Sparod/AirCat-A10/hardware/datasheet/image/650px-A10-OLinuXino-LIME-FRONT.jpg

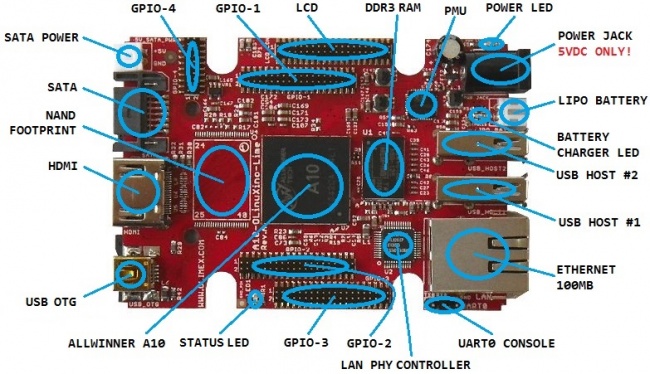
hardware/datasheet/image/650px-A10-OLinuXino-LIME-FRONT.jpg
