Sparod/AirCat-A10/hardware/datasheet/image/650px-A10-OLinuXino-LIME-BACK.jpg

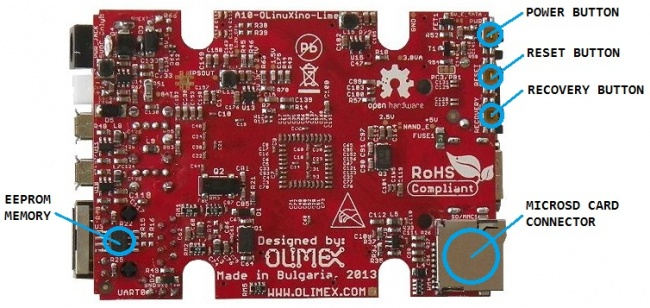
hardware/datasheet/image/650px-A10-OLinuXino-LIME-BACK.jpg
