Sparod/AirCat-A10/hardware/datasheet/image/a10-olinuxino.png

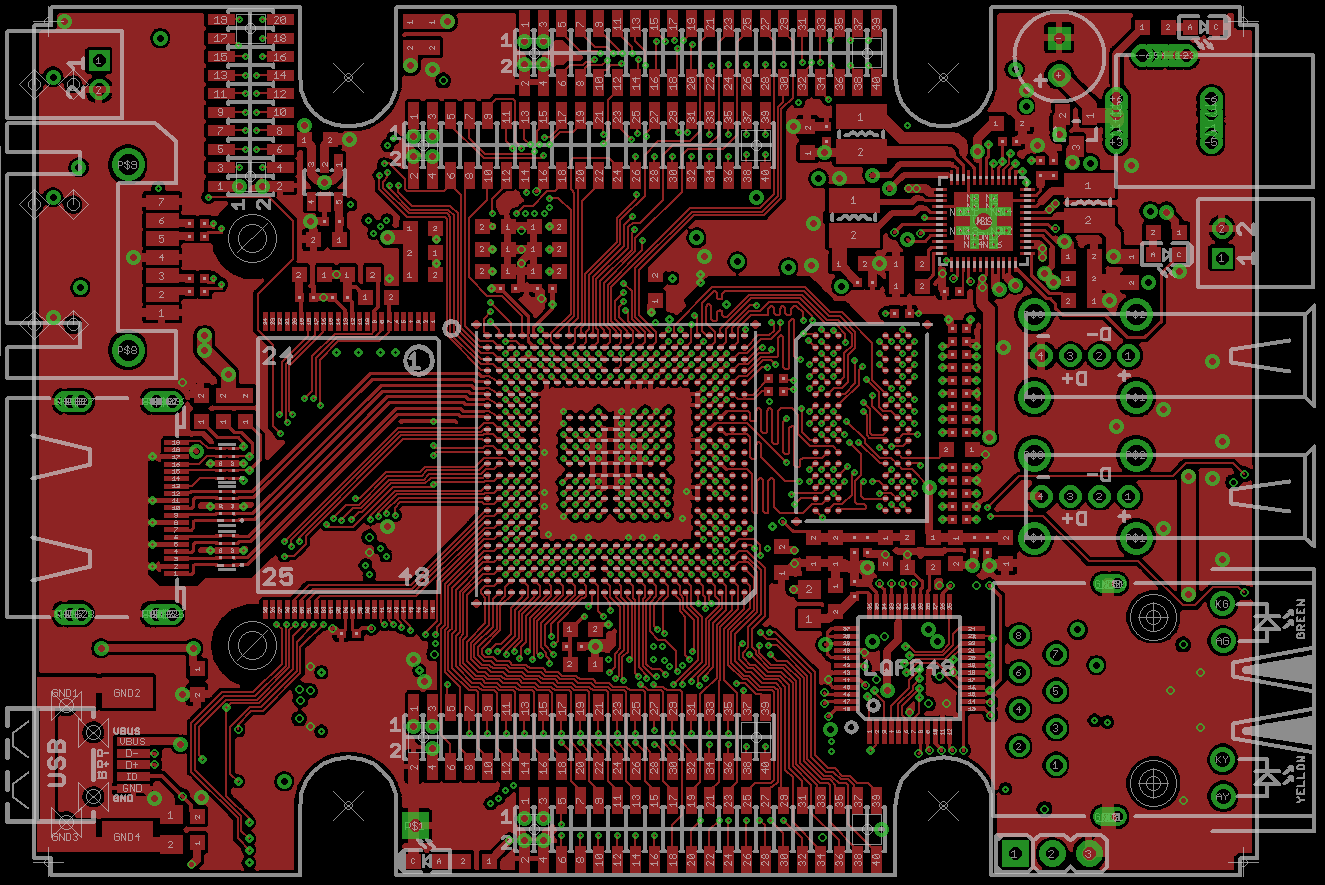
hardware/datasheet/image/a10-olinuxino.png
