Sparod/AirCat-A10/hardware/eagle/OSHpark_Board_Outline.png

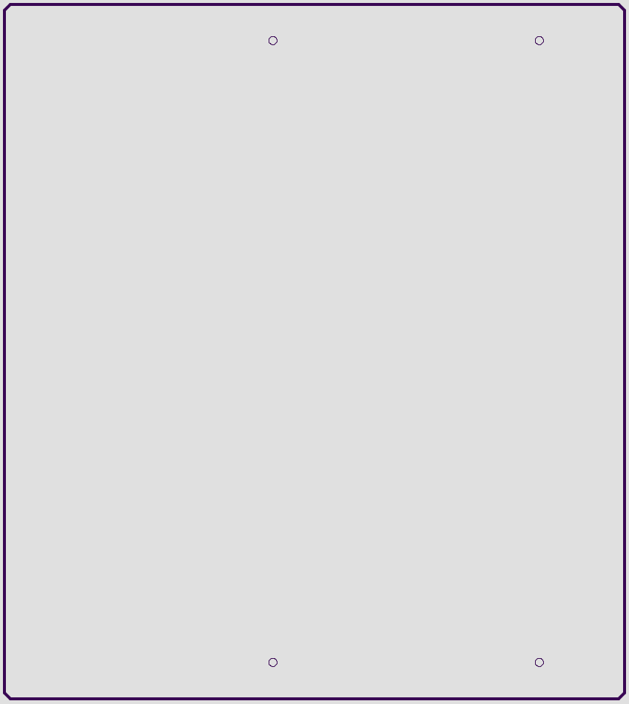
hardware/eagle/OSHpark_Board_Outline.png
