Sparod/AirCat-A10/hardware/eagle/OSHpark_bottom.png

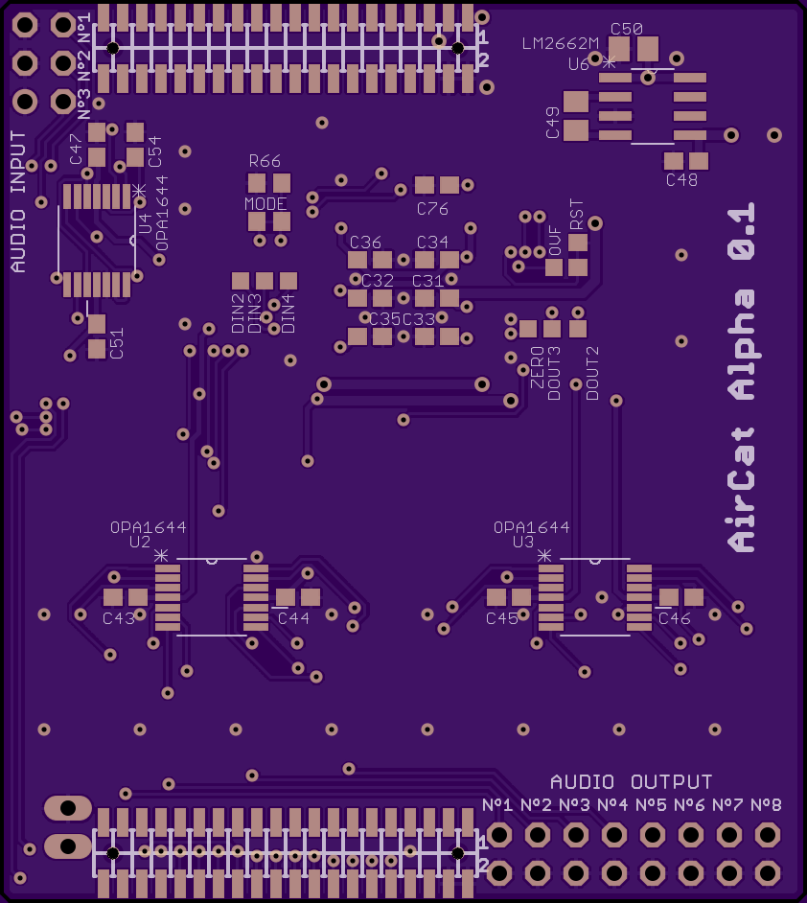
hardware/eagle/OSHpark_bottom.png
