Sparod/AirCat-A10/hardware/eagle/OSHpark_bottom_copper.png

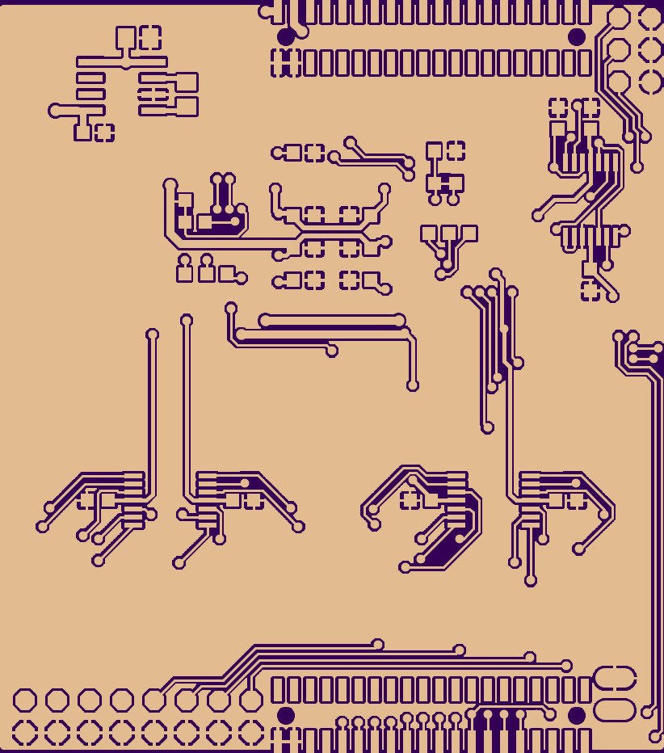
hardware/eagle/OSHpark_bottom_copper.png
