Sparod/AirCat-A10/hardware/eagle/OSHpark_bottom_Silk_Screen.png

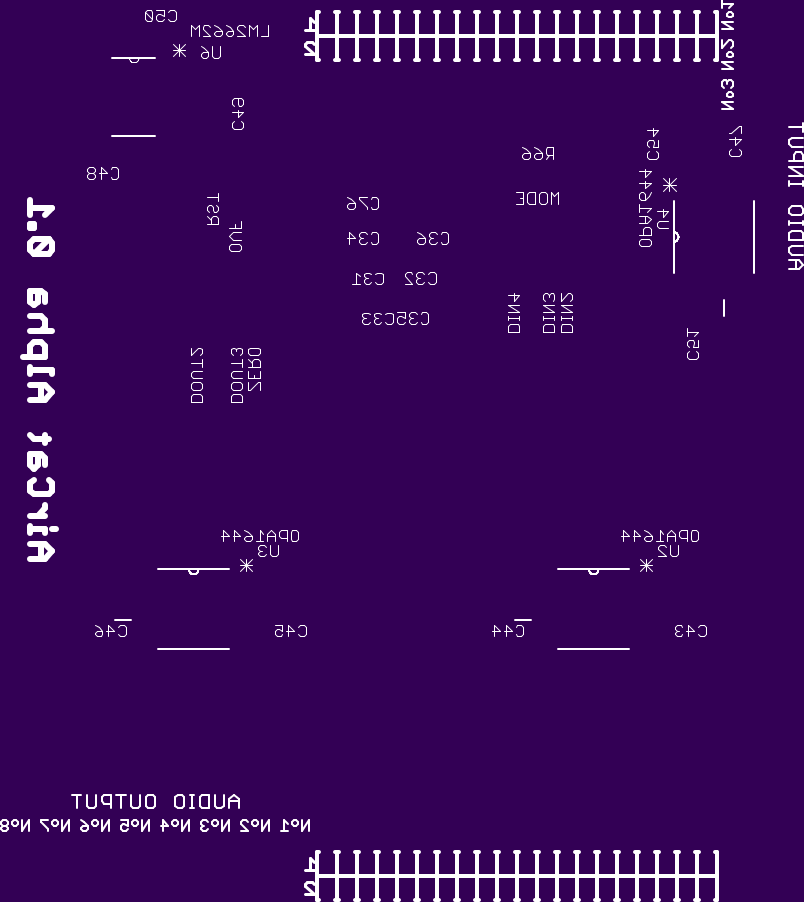
hardware/eagle/OSHpark_bottom_Silk_Screen.png
