Sparod/AirCat-A10/hardware/eagle/OSHpark_Drills.png

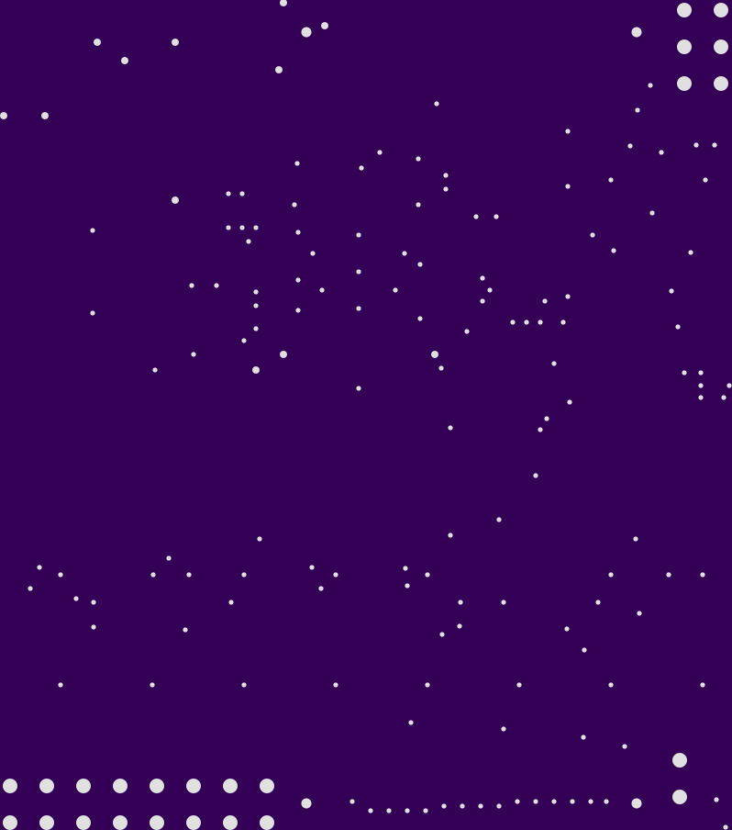
hardware/eagle/OSHpark_Drills.png
