Sparod/AirCat-A10/hardware/eagle/OSHpark_top.png

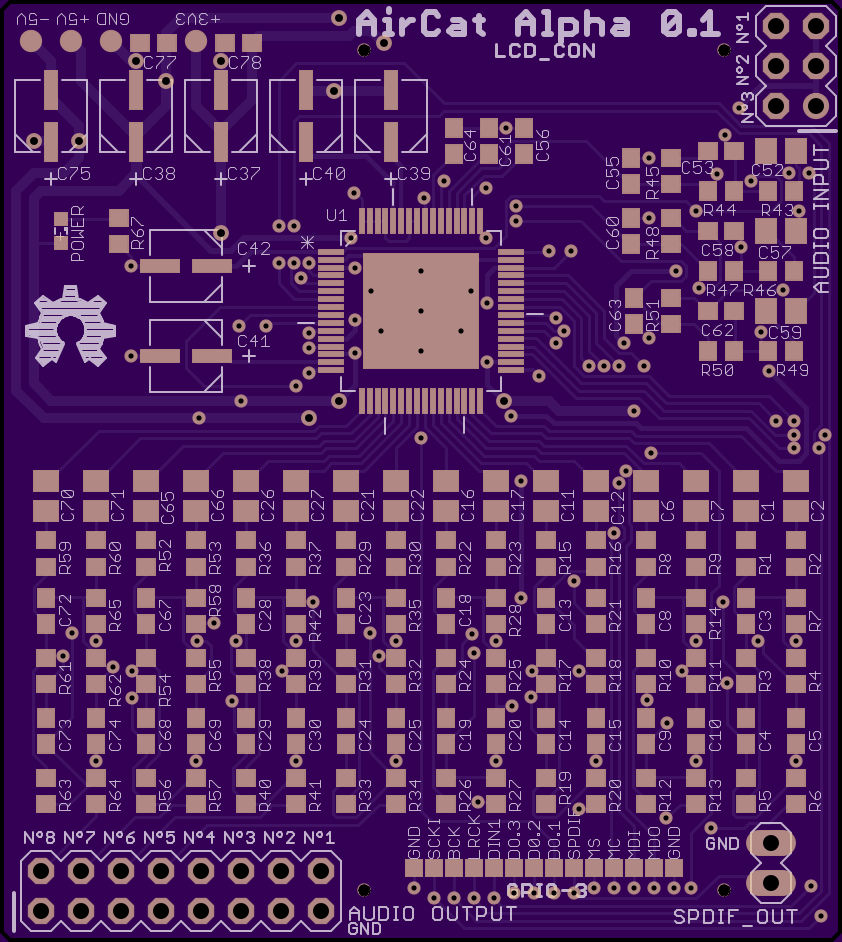
hardware/eagle/OSHpark_top.png
