Sparod/AirCat-A10/hardware/eagle/OSHpark_top_copper.png

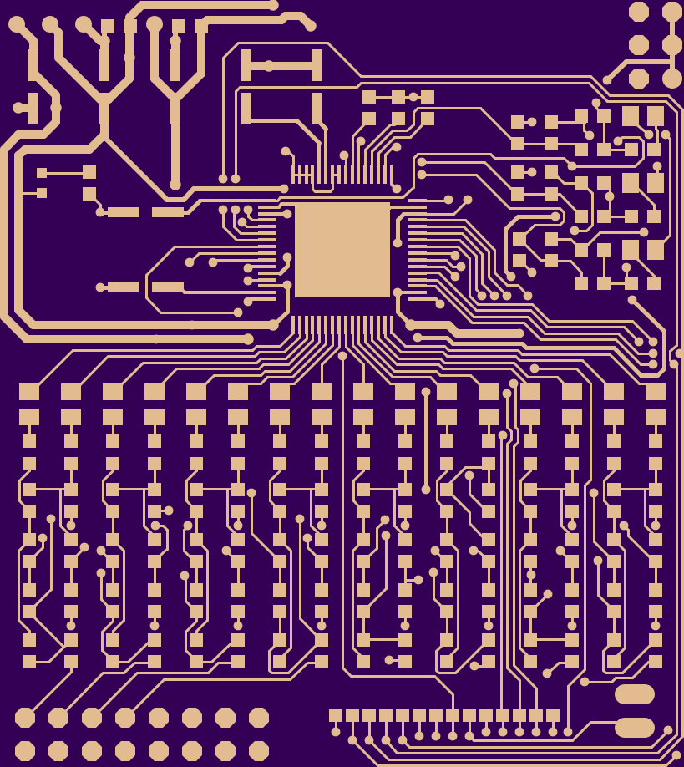
hardware/eagle/OSHpark_top_copper.png
