Sparod/AirCat-A10/hardware/eagle/OSHpark_top_Silk_Screen.png

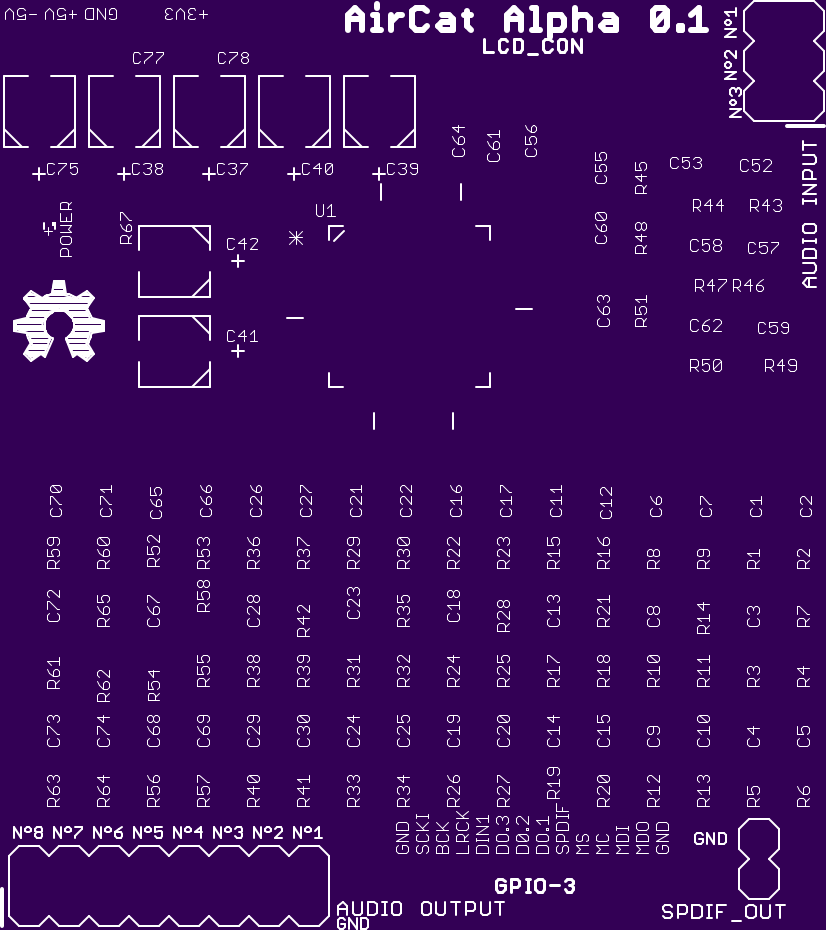
hardware/eagle/OSHpark_top_Silk_Screen.png
