Sparod/AirCat-A10/hardware/eagle/bom.xlsx

Sheet: BOM
AirCat audio shield - BOM
taxes excluded
category | value/description | manufacturer name | manufacturer ref | vendor name | vendor ref | qty | € / u / 1pc | € / u / 100pcs | € / 1pc | € / 100pc | link | datasheet
capacitor | SMD BOITIER B 10µF 35V | PANASONIC | EEEFK1V100UR | Farnell | 2254444 | 7 | 0.410 | 0.148 | 2.870 | 1.036 | http://fr.farnell.com/panasonic/eeefk1v100ur/condensateur-boitier-b-10uf-35v/dp/9695826 | http://www.farnell.com/datasheets/1676921.pdf
capacitor | SMD 0805" 10 µF | MULTICOMP | MCCA000268 | Farnell | 1759136 | 21 | 0.048 | 0.048 | 1.008 | 1.008 | http://fr.farnell.com/multicomp/mcca000268/condensateur-mlcc-08055v-6-3v-10uf/dp/1759136 | http://www.farnell.com/datasheets/1723208.pdf
capacitor | SMD 0603" 1 µF | MULTICOMP | MCCA000521 | Farnell | 1759398 | 12 | 0.009 | 0.009 | 0.108 | 0.108 | http://fr.farnell.com/multicomp/mcca000521/condensateur-mlcc-06035v-10v-1uf/dp/1759398 | http://www.farnell.com/datasheets/1723208.pdf
capacitor | SMD 0603" 680 pF | MULTICOMP | MC0603B681K500CT | Farnell | 1759083 | 16 | 0.007 | 0.006 | 0.112 | 0.096 | http://fr.farnell.com/multicomp/mc0603b681k500ct/condensateur-mlcc-0603-x7r-50v/dp/1759083 | http://www.farnell.com/datasheets/1792107.pdf
capacitor | SMD 0603" 3.3 nF | MULTICOMP | MC0603B332J500CT | Farnell | 2320807 | 8 | 0.008 | 0.007 | 0.064 | 0.056 | http://fr.farnell.com/multicomp/mc0603b332j500ct/condensateur-mlcc-3-3nf-50v-x7r/dp/2320807 | http://www.farnell.com/datasheets/1792107.pdf
capacitor | SMD 0603" 22 nF | MULTICOMP | MC0603B223K250CT | Farnell | 1759027 | 6 | 0.009 | 0.008 | 0.054 | 0.048 | http://fr.farnell.com/multicomp/mc0603b223k250ct/condensateur-mlcc-0603-x7r-25v/dp/1759027 | http://www.farnell.com/datasheets/1792107.pdf
capacitor | SMD 0603" 2.2 nF | MULTICOMP | MC0603B222J500CT | Farnell | 2320806 | 6 | 0.009 | 0.008 | 0.054 | 0.048 | http://fr.farnell.com/multicomp/mc0603b223k250ct/condensateur-mlcc-0603-x7r-25v/dp/1759027 | http://www.farnell.com/datasheets/1792107.pdf
capacitor | SMD 0603" 100 nF | MULTICOMP | MC0603B104K250CT | Farnell | 1759037 | 5 | 0.007 | 0.006 | 0.035 | 0.030 | http://fr.farnell.com/multicomp/mc0603b104k250ct/condensateur-mlcc-0603-x7r-25v/dp/1759037 | http://www.farnell.com/datasheets/1792107.pdf
connector | 0.1" male thru-hole 2x08 | MULTICOMP | 2213S-16G | Farnell | 1593445 | 1 | 0.830 | 0.640 | 0.830 | 0.640 | http://fr.farnell.com/multicomp/2213s-16g/embase-male-2-rangee-vert-16voies/dp/1593445 | http://www.farnell.com/datasheets/1697539.pdf
connector | 0.05" female SMD 2x20 | OLIMEX | FEMALE-YAV36P-2x20 | OLIMEX | FEMALE-YAV36P-2x20 | 2 | 0.320 | 0.256 | 0.640 | 0.512 | https://www.olimex.com/Products/Components/Connectors/FEMALE-YAV36P-2x20/
connector | 0.1" male thru-hole 2x03 | MULTICOMP | 2213S-06G | Farnell | 1593440 | 1 | 0.360 | 0.320 | 0.360 | 0.320 | http://fr.farnell.com/multicomp/2213s-06g/embase-male-2-rangee-vert-6voies/dp/1593440?Ntt=2213S-06G | http://www.farnell.com/datasheets/1697530.pdf
connector | 0.05" male SMD 1x2 | MULTICOMP | 2211S-02G | Farnell | 1593411 | 1 | 0.065 | 0.027 | 0.065 | 0.027 | http://fr.farnell.com/multicomp/2211s-02g/embase-male-1-rangee-vert-2voies/dp/1593411 | http://www.farnell.com/datasheets/1518407.pdf
ic | audio op amp | TEXAS INSTRUMENTS | OPA1644AIPW | Farnell | 1882283 | 3 | 4.880 | 3.470 | 14.640 | 10.410 | http://fr.farnell.com/texas-instruments/opa1644aipw/ampli-op-jfet-11mhz-quad-14tssop/dp/1882283 | http://www.farnell.com/datasheets/1633936.pdf
ic | audio codec | TEXAS INSTRUMENTS | PCM3168APAP | Farnell | 1689419 | 1 | 11.860 | 5.830 | 11.860 | 5.830 | http://fr.farnell.com/texas-instruments/pcm3168apap/24bit-audio-code-64tqfp/dp/1689419?ref=lookahead | http://www.farnell.com/datasheets/1815267.pdf
ic | buck tension converter | TEXAS INSTRUMENTS | LM2662M | Farnell | 9306803 | 1 | 1.700 | 1.510 | 1.700 | 1.510 | http://fr.farnell.com/texas-instruments/lm2662m/convertisseur-de-tension-cms/dp/9306803 | http://www.farnell.com/datasheets/77958.pdf
led | SMD 0603" Green 10mcd | KINGBRIGHT | KP-1608SGC | Farnell | 8529833 | 1 | 0.076 | 0.069 | 0.076 | 0.069 | http://fr.farnell.com/kingbright/kp-1608sgc/led-cms-0603-vert/dp/8529833 | http://www.farnell.com/datasheets/55768.pdf
pcb |  |  |  | OHSpark.com |  | 1 | 4.949 | 0.990 | 4.949 | 0.990 | oshpark.com
resistor | SMD 0603" 5.6kR | MULTICOMP | MCMR06X5601FTL | Farnell | 2073537 | 16 | 0.008 | 0.008 | 0.128 | 0.128 | http://fr.farnell.com/multicomp/mcmr06x5601ftl/resistance-0603-5k6-1-anti-sulfur/dp/2073537 | http://www.farnell.com/datasheets/1716707.pdf
resistor | SMD 0603" 7.5kR | MULTICOMP | MCMR06X7501FTL | Farnell | 2073570 | 16 | 0.008 | 0.008 | 0.128 | 0.128 | http://fr.farnell.com/multicomp/mcmr06x7501ftl/resistance-0603-7k5-1-anti-sulfur/dp/2073570 | http://www.farnell.com/datasheets/1716707.pdf
resistor | SMD 0603" 3kR | MULTICOMP | MCMR06X3001FTL | Farnell | 2073461 | 3 | 0.008 | 0.008 | 0.024 | 0.024 | http://fr.farnell.com/multicomp/mcmr06x3001ftl/resistance-0603-3k-1-anti-sulfur/dp/2073461 | http://www.farnell.com/datasheets/1716707.pdf
resistor | SMD 0603" 150R | MULTICOMP | MCMR06X1500FTL | Farnell | 2073388 | 1 | 0.009 | 0.009 | 0.009 | 0.009 | http://fr.farnell.com/multicomp/mcmr06x1500ftl/resistance-0603-150r-1-anti-sulfur/dp/2073388 | http://www.farnell.com/datasheets/1716707.pdf
resistor | SMD 0603" 220kR | YAGEO (PHYCOMP) | RC0603FR-07220KL | Farnell | 9238760 | 1 | 0.005 | 0.005 | 0.005 | 0.005 | http://fr.farnell.com/yageo-phycomp/rc0603fr-07220kl/resistance-rc22h-0603-220k/dp/9238760 | http://www.farnell.com/datasheets/443971.pdf
TOTAL |  |  |  |  |  | 130 |  |  | 39.72 € | 23.03 €
taxe rate = | 20% | France VAT |  |  |  |  |  | taxes | 7.94 € | 4.61 €
 |  |  |  |  |  |  |  | grand total | 47.66 € | 27.64 €

Sheet: other
2pcs Video AV Balun 3.5mm 1/8"stereo male plug to AV Screw Terminal Plug adapter | http://www.ebay.com/itm/2pcs-Video-AV-Balun-3-5mm-1-8-stereo-male-plug-to-AV-Screw-Terminal-Plug-adapter-/231204744595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
Audio 4 Female Jack RCA Socket Connectors (10-Piece Pack) | http://www.dx.com/p/audio-4-female-jack-rca-socket-connectors-10-piece-pack-138307
Replacement Audio RCA Chassis Connectors - Red + Black + Silver (10-Pack) | http://www.dx.com/p/dual-sockets-3-5mm-av-jack-connectors-red-black-silver-10-pack-122545
Double-Side QFP / QFN / TQFP / LQFP 16-80-pin to DIP Adapter | http://www.dx.com/p/double-side-qfp-qfn-tqfp-lqfp-16-80-pin-to-dip-adapter-breakout-board-module-for-arduino-206458
Jtron Aluminum PCB / Receiver Shell / Junction Box - Black | http://www.dx.com/p/jtron-aluminum-pcb-receiver-shell-junction-box-black-290724
Dual-Channel Audio RCA Socket (5 PCS) | http://www.dx.com/p/dual-channel-audio-rca-socket-5-pcs-303101
