Sparod/AirCat-A10/hardware/eagle/partlist.txt

Partlist

Exported from aircat.brd at 09/05/2014 18:37:59

EAGLE Version 6.1.0 Copyright (c) 1988-2012 CadSoft

Assembly variant: 

Part      Value                              Package                   Library                        Position (inch)       Orientation

BCKAD/DA                                     TP10SQ                    testpad                        (0.08125 -0.99375)    R0
C1        10µF 16V                           C0805                     rcl                            (0.8125 -0.0625)      R270
C2        10µF 16V                           C0805                     rcl                            (0.9375 -0.0625)      R270
C3        3300pF                             C0603                     rcl                            (0.8125 -0.35)        R90
C4        680pF                              C0603                     rcl                            (0.8125 -0.65)        R270
C5        680pF                              C0603                     rcl                            (0.9375 -0.65)        R270
C6        10µF 16V                           C0805                     rcl                            (0.5625 -0.0625)      R270
C7        10µF 16V                           C0805                     rcl                            (0.6875 -0.0625)      R270
C8        3300pF                             C0603                     rcl                            (0.5625 -0.35)        R90
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
C65       10µF 16V                           C0805                     rcl                            (-0.6875 -0.0625)     R270
C66       10µF 16V                           C0805                     rcl                            (-0.5625 -0.0625)     R270
C67       3300pF                             C0603                     rcl                            (-0.6875 -0.35)       R90
C68       680pF                              C0603                     rcl                            (-0.6875 -0.65)       R270
C69       680pF                              C0603                     rcl                            (-0.5625 -0.65)       R270
C70       10µF 16V                           C0805                     rcl                            (-0.9375 -0.0625)     R270
C71       10µF 16V                           C0805                     rcl                            (-0.8125 -0.0625)     R270
C72       3300pF                             C0603                     rcl                            (-0.9375 -0.35)       R90
C73       680pF                              C0603                     rcl                            (-0.9375 -0.65)       R270
C74       680pF                              C0603                     rcl                            (-0.8125 -0.65)       R270
C75       10µF                               CAPAE430X610N             Panasonic-EEEFK_EEEFP          (-0.925 0.8875)       R90
C76       0.001-1µF                          C0603                     rcl                            (-0.0875 0.69375)     MR180
C77       100nF                              C0603                     rcl                            (-0.66875 1.06875)    R180
C78       100nF                              C0603                     rcl                            (-0.45625 1.06875)    R180
CON1      A10_OLINUXINO_LIME_SHIELD_TEMPLATE A10_OLINUXINO_LIME_SHIELD A10_OLIMEXINO_LIME_SHIELD_edit (0 0)                 R0
CON2      ANALOG_OUT                         MA08-2                    con-lstb-without-pin-numbers   (-0.6 -1.05)          R0
CON3      ANALOG_IN                          MA03-2                    con-lstb-without-pin-numbers   (0.9375 1.0125)       R90
CON4      SPDIF_OUT                          MA02-1                    con-lstb-without-pin-numbers   (0.875 -0.98125)      R270
DIN1                                         TP10SQ                    testpad                        (0.18125 -0.99375)    R0
DIN2                                         TP10SQ                    testpad                        (0.425 0.44375)       MR180
DIN3                                         TP10SQ                    testpad                        (0.3625 0.44375)      MR180
DIN4                                         TP10SQ                    testpad                        (0.3 0.44375)         MR180
DOUT1                                        TP10SQ                    testpad                        (0.33125 -0.99375)    R0
DOUT2                                        TP10SQ                    testpad                        (-0.45625 0.31875)    MR0
DOUT2(NC) TPTP10SQ                           TP10SQ                    testpad                        (0.28125 -0.99375)    R0
DOUT3                                        TP10SQ                    testpad                        (-0.3875 0.31875)     MR0
DOUT3(NC) TPTP10SQ                           TP10SQ                    testpad                        (0.23125 -0.99375)    R0
GND@1     TPTP10SQ                           TP10SQ                    testpad                        (-0.01875 -0.99375)   R0
GND@2     TPTP10SQ                           TP10SQ                    testpad                        (0.63125 -0.99375)    R0
LRCKAD/DA                                    TP10SQ                    testpad                        (0.13125 -0.99375)    R0
MC                                           TP10SQ                    testpad                        (0.48125 -0.99375)    R0
MDI                                          TP10SQ                    testpad                        (0.53125 -0.99375)    R0
MDO                                          TP10SQ                    testpad                        (0.58125 -0.99375)    R0
MODE      0 Ohm                              R0603                     rcl                            (0.35 0.6)            MR0
MS                                           TP10SQ                    testpad                        (0.43125 -0.99375)    R0
OVF       TPTP10SQ                           TP10SQ                    testpad                        (-0.39375 0.479)      MR0
POWER                                        SML0603                   led                            (-0.9 0.65)           R270
R1        7.5k                               R0603                     rcl                            (0.8125 -0.20625)     R270
R2        7.5k                               R0603                     rcl                            (0.9375 -0.20625)     R270
R3        360                                R0603                     rcl                            (0.8125 -0.5)         R270
R4        360                                R0603                     rcl                            (0.9375 -0.5)         R270
R5        5.6k                               R0603                     rcl                            (0.8125 -0.8)         R90
R6        47                                 R0603                     rcl                            (0.9375 -0.8)         R270
R7        5.6k                               R0603                     rcl                            (0.9375 -0.35)        R90
R8        7.5k                               R0603                     rcl                            (0.5625 -0.20625)     R270
R9        7.5k                               R0603                     rcl                            (0.6875 -0.20625)     R270
R10       360                                R0603                     rcl                            (0.5625 -0.5)         R270
R11       360                                R0603                     rcl                            (0.6875 -0.5)         R270
R12       5.6k                               R0603                     rcl                            (0.5625 -0.8)         R90
R13       47                                 R0603                     rcl                            (0.6875 -0.8)         R270
R14       5.6k                               R0603                     rcl                            (0.6875 -0.35)        R90
R15       7.5k                               R0603                     rcl                            (0.3125 -0.20625)     R270
R16       7.5k                               R0603                     rcl                            (0.4375 -0.20625)     R270
R17       360                                R0603                     rcl                            (0.3125 -0.5)         R270
R18       360                                R0603                     rcl                            (0.4375 -0.5)         R270
R19       5.6k                               R0603                     rcl                            (0.3125 -0.8)         R90
R20       47                                 R0603                     rcl                            (0.4375 -0.8)         R270
R21       5.6k                               R0603                     rcl                            (0.4375 -0.35)        R90
R22       7.5k                               R0603                     rcl                            (0.0625 -0.20625)     R270
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
R56       5.6k                               R0603                     rcl                            (-0.6875 -0.8)        R270
R57       47                                 R0603                     rcl                            (-0.5625 -0.8)        R270
R58       5.6k                               R0603                     rcl                            (-0.5625 -0.35)       R90
R59       7.5k                               R0603                     rcl                            (-0.9375 -0.20625)    R270
R60       7.5k                               R0603                     rcl                            (-0.8125 -0.20625)    R270
R61       360                                R0603                     rcl                            (-0.9375 -0.5)        R270
R62       360                                R0603                     rcl                            (-0.8125 -0.5)        R270
R63       5.6k                               R0603                     rcl                            (-0.9375 -0.8)        R270
R64       47                                 R0603                     rcl                            (-0.8125 -0.8)        R270
R65       5.6k                               R0603                     rcl                            (-0.8125 -0.35)       R90
R66       220k                               R0603                     rcl                            (0.35 0.7)            MR0
R67       150                                R0603                     rcl                            (-0.75625 0.65)       R90
RST       0 Ohm                              R0603                     rcl                            (-0.45625 0.5125)     MR90
SCKI                                         TP10SQ                    testpad                        (0.03125 -0.99375)    R0
SPDIF_DO  TPTP10SQ                           TP10SQ                    testpad                        (0.38125 -0.99375)    R0
TP1       -5V                                B1,27                     testpad                        (-0.975 1.075)        R0
TP2       +5V                                B1,27                     testpad                        (-0.875 1.075)        R0
TP3       GND                                B1,27                     testpad                        (-0.775 1.075)        R0
TP4       +3V3                               B1,27                     testpad                        (-0.5625 1.075)       R0
U1        PCM3168A                           QFP50P1200X1200X120-65N   pcm3168                        (0 0.4)               R0
U2        OPA1644AIPW                        SOP65P640X120-14N         OPA1644                        (0.5 -0.38125)        MR0
U3        OPA1644AIPW                        SOP65P640X120-14N         OPA1644                        (-0.5 -0.38125)       MR0
U4        OPA1644AIPW                        SOP65P640X120-14N         OPA1644                        (0.8 0.55)            MR270
U6        LM2662M                            SOIC127P620X175-8N        TI-LM2662M                     (-0.85 0.9)           MR0
ZERO                                         TP10SQ                    testpad                        (-0.325 0.31875)      MR0
