Sparod/AirCat-A10/hardware/eagle/OSHpark_bottom_Solder_Mask.png

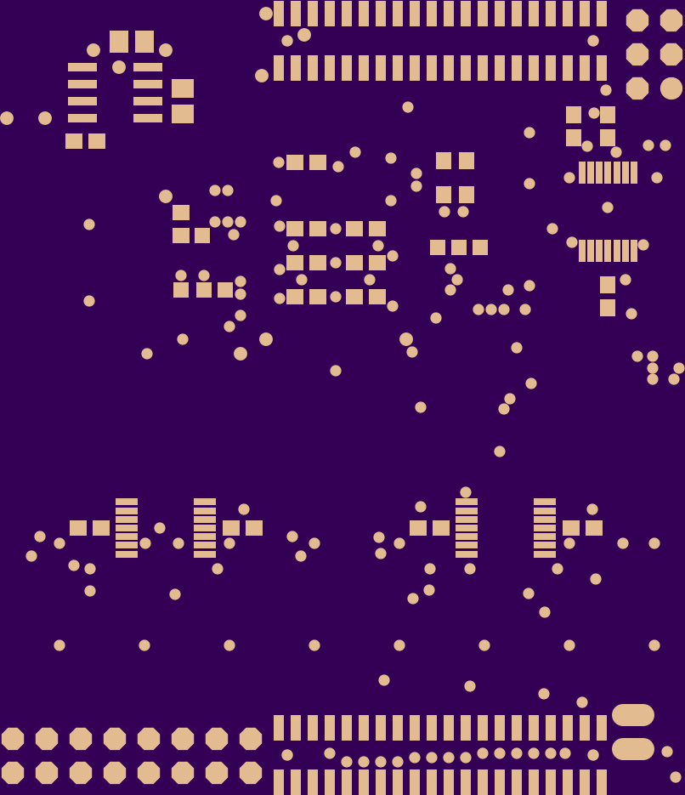
hardware/eagle/OSHpark_bottom_Solder_Mask.png
