Sparod/AirCat-A10/hardware/eagle/OSHpark_top_Solder Mask.png

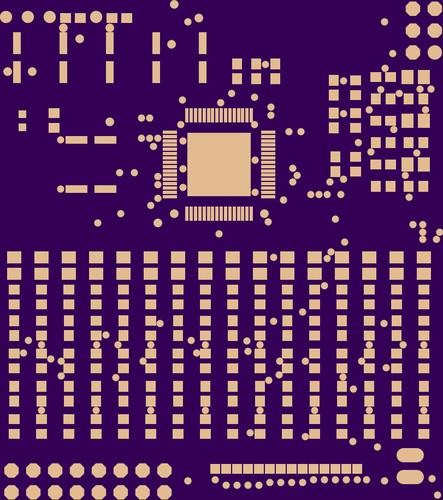
hardware/eagle/OSHpark_top_Solder Mask.png
