Sparod/AirCat-A10/hardware/eagle/aircat_all.pdf

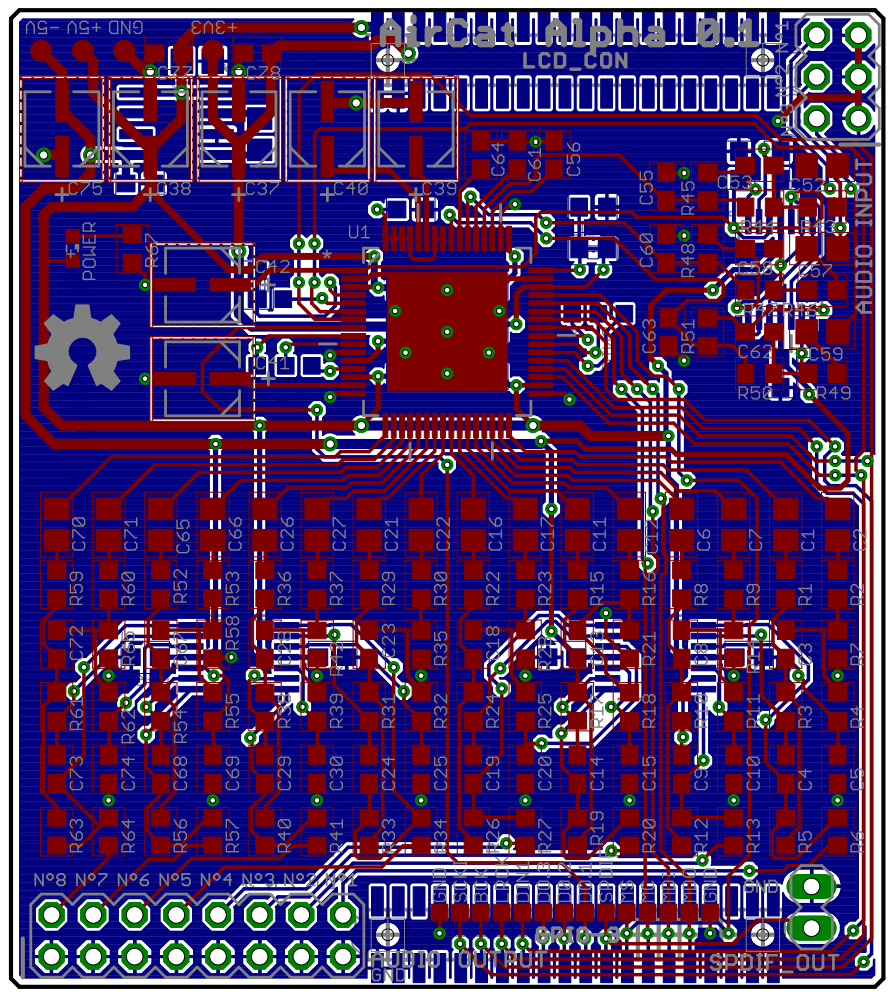
[picture p14: page 1]
