Sparod/AirCat-A10/hardware/eagle/aircat_bottom.pdf

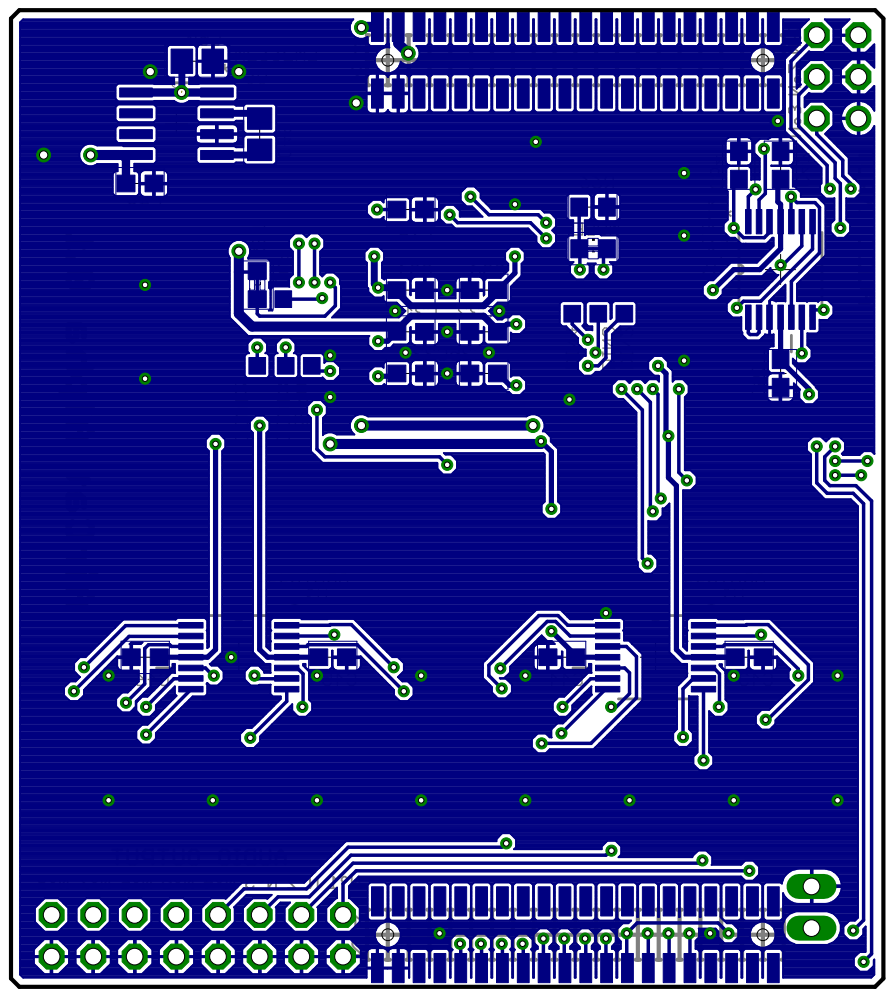
[picture p15: page 1]
