Sparod/AirCat-A10/hardware/eagle/aircat_top.pdf

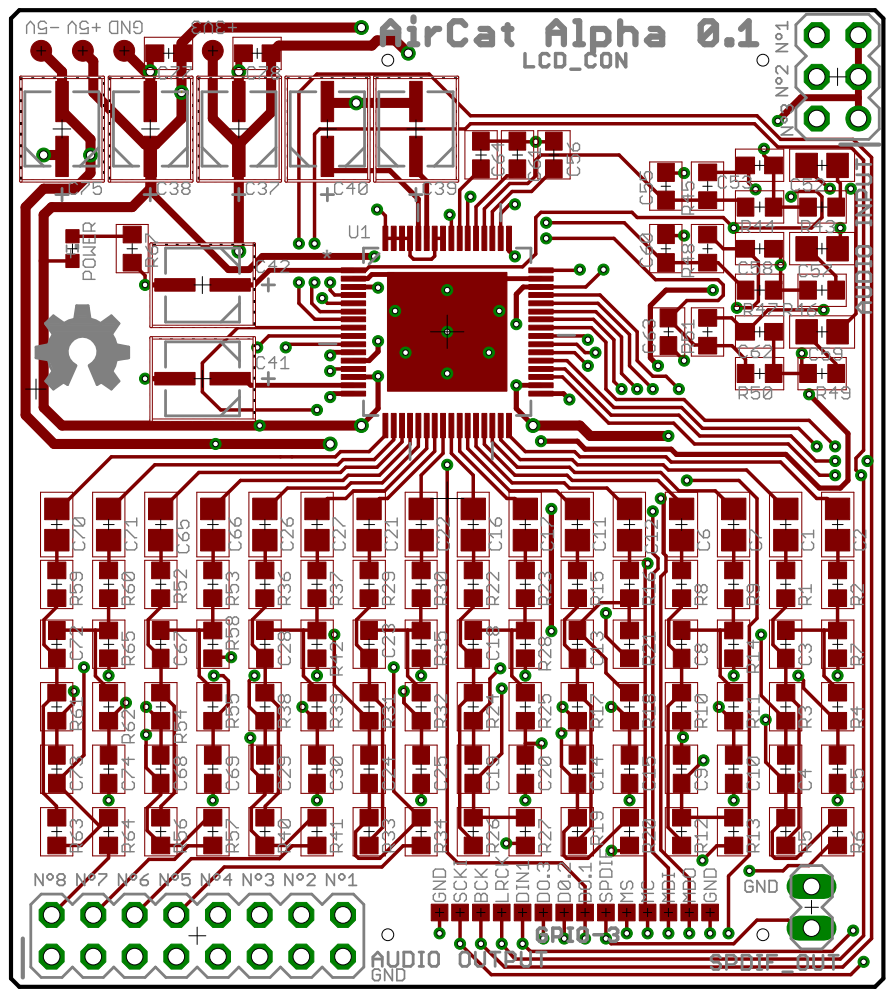
[picture p16: page 1]
