Sparod/AirCat-A10/hardware/eagle/aircat.brd

## EAGLE design hardware/eagle/aircat.brd (2014-05-19)

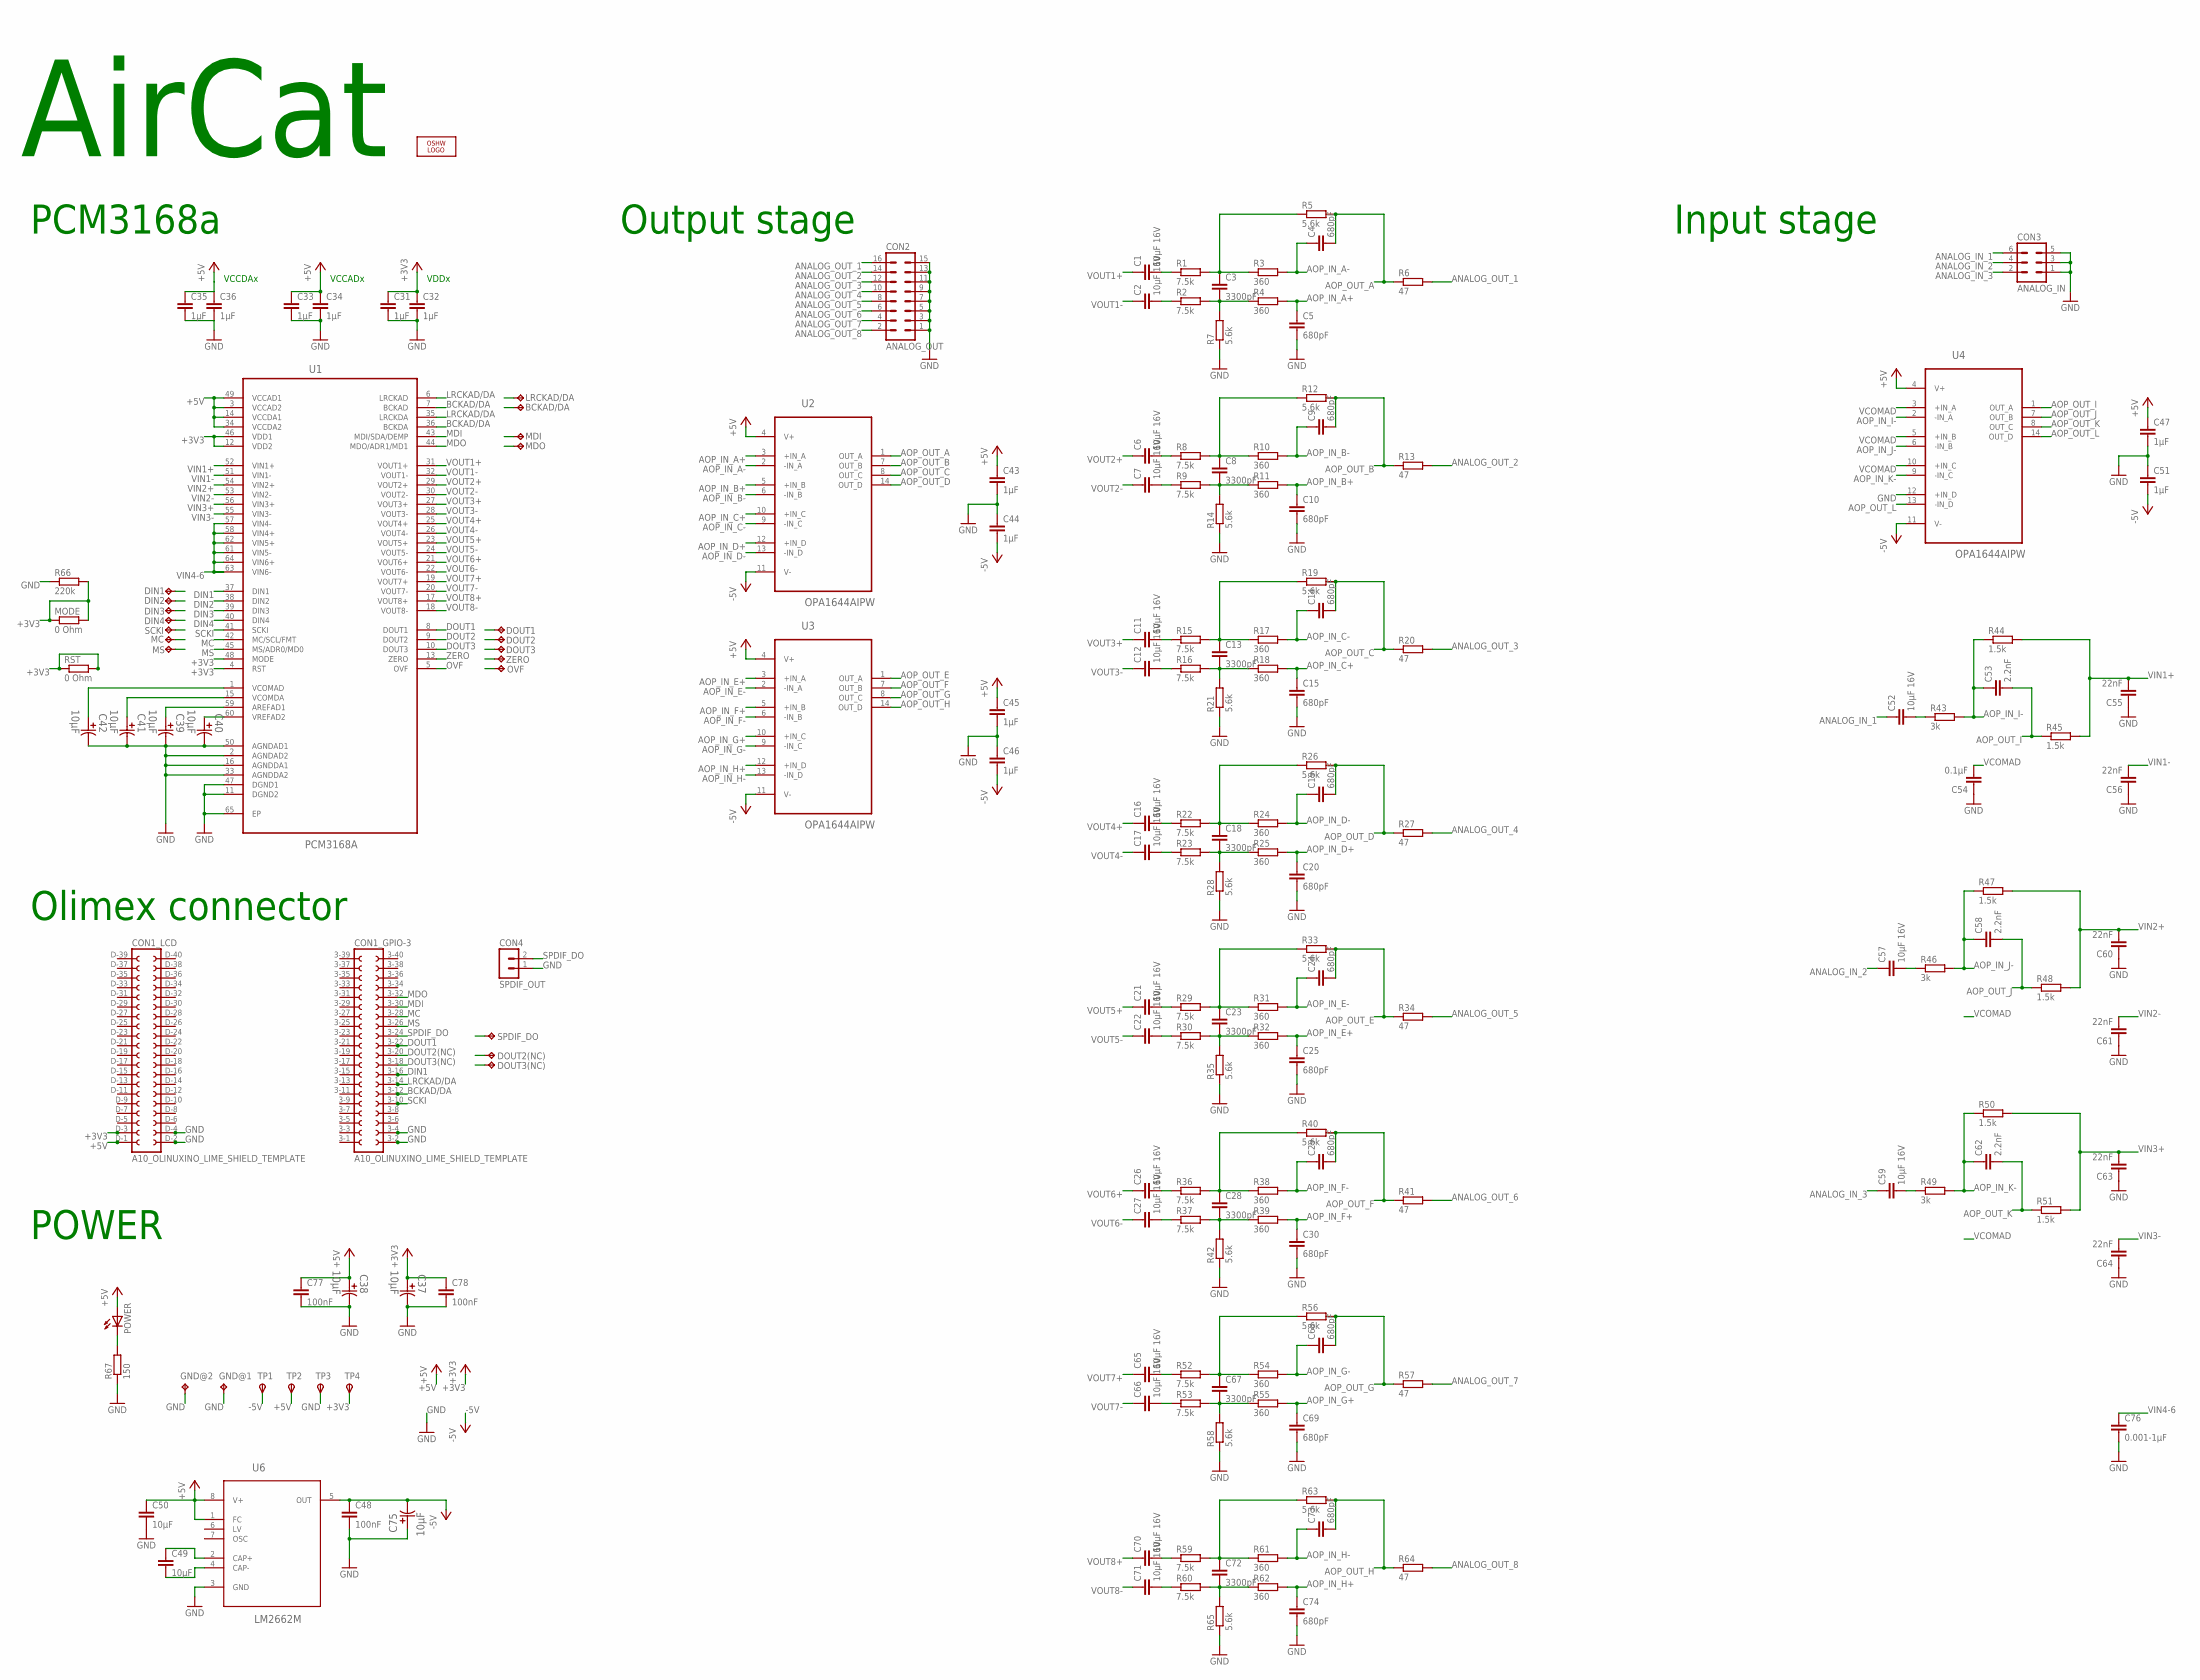
[picture p17: schematic aircat.sch]

Parts:
BCKAD/DA: TPTP10SQ; TP10SQ
C1, C2, C6, C7, C11, C12, C16, C17, C21, C22, C26, C27, C52, C57, C59, C65, C66, C70, C71: 10µF 16V; C0805; MPN 1206YD106KAT2A
C3, C8, C13, C18, C23, C28, C67, C72: 3300pF; C0603; MPN 06035C332KAT2A
C4, C5, C9, C10, C14, C15, C19, C20, C24, C25, C29, C30, C68, C69, C73, C74: 680pF; C0603; MPN C0603C681J5GACTU
C31, C32, C33, C34, C35, C36, C43, C44, C45, C46, C47, C51: 1µF; C0603; MPN 0603ZD105KAT2A
C37: 10µF; CAPAE430X610N; MPN EEEFK1V100UR
C38, C39, C40, C41, C42, C75: 10µF; CAPAE430X610N; TOLERANCE ±20 %; VOLTAGERATING 35V; MPN EEEFK1V100UR
C48: 100nF; C0603; MPN 10SVP10M
C49, C50: 10µF; C0805; MPN 10SVP10M
C53, C58, C62: 2.2nF; C0603; MPN 06035C222KAT2A
C54: 0.1µF; C0603; MPN 0402YD104KAT2A
C55, C56, C60, C61, C63, C64: 22nF; C0603; MPN 06033C223KAT2A
C76: 0.001-1µF; C0603
C77, C78: 100nF; C0603; MPN 06033D104KAT2A
CON1: A10_OLINUXINO_LIME_SHIELD_TEMPLATE; A10_OLINUXINO_LIME_SHIELD
CON2: ANALOG_OUT; MA08-2
CON3: ANALOG_IN; MA03-2
CON4: SPDIF_OUT; MA02-1
DIN1, DIN2, DIN3, DIN4: TPTP10SQ; TP10SQ
DOUT1, DOUT2, DOUT2(NC), DOUT3, DOUT3(NC): TPTP10SQ; TP10SQ
GND@1, GND@2: TPTP10SQ; TP10SQ
LOGO1: OSHW_LOGO_FILLX0200-NT; OSHW_FILLX200_NOTEXT
LRCKAD/DA: TPTP10SQ; TP10SQ
MC: TPTP10SQ; TP10SQ
MDI: TPTP10SQ; TP10SQ
MDO: TPTP10SQ; TP10SQ
MODE: 0 Ohm; R0603
MS: TPTP10SQ; TP10SQ
OVF: TPTP10SQ; TP10SQ
POWER: LEDSML0603; SML0603
R1, R2, R8, R9, R15, R16, R22, R23, R29, R30, R36, R37, R52, R53, R59, R60: 7.5k; R0603; MPN MCRE000161
R3, R4, R10, R11, R17, R18, R24, R25, R31, R32, R38, R39, R54, R55, R61, R62: 360; R0603
R5, R7, R12, R14, R19, R21, R26, R28, R33, R35, R40, R42, R56, R58, R63, R65: 5.6k; R0603; MPN MCPWR05FTEW5601
R6, R13, R20, R27, R34, R41, R57, R64: 47; R0603
R43, R46, R49: 3k; R0603; MPN 167I 3K TX 9 X 80 MM
R44, R45, R47, R48, R50, R51: 1.5k; R0603
R66: 220k; R0603
R67: 150; R0603; MPN MCRE000161
RST: 0 Ohm; R0603
SCKI: TPTP10SQ; TP10SQ
SPDIF_DO: TPTP10SQ; TP10SQ
TP1: -5V; B1,27
TP2: +5V; B1,27
TP3: GND; B1,27
TP4: +3V3; B1,27
U1: PCM3168A; QFP50P1200X1200X120-65N; MPN PCM3168APAP
U2, U3, U4: OPA1644AIPW; SOP65P640X120-14N; MPN OPA1644AIPW
U6: LM2662M; SOIC127P620X175-8N; MPN LM2662M
ZERO: TPTP10SQ; TP10SQ

Connections:
+3V3: C31.1, C32.1, C37.1, C78.1, CON1.D-3 (3), MODE.1, MODE.2, R66.2, RST.1, RST.2, TP4.TP, U1.4 (RST), U1.12 (VDD2), U1.46 (VDD1), U1.48 (MODE)
+5V: C33.1, C34.1, C35.1, C36.1, C38.1, C43.1, C45.1, C47.1, C50.1, C77.1, CON1.D-1 (1), POWER.A, TP2.TP, U1.3 (VCCAD2), U1.14 (VCCDA1), U1.34 (VCCDA2), U1.49 (VCCAD1), U2.4 (V+), U3.4 (V+), U4.4 (V+), U6.1 (FC), U6.8 (V+)
-5V: C44.2, C46.2, C48.1, C51.2, C75.2, TP1.TP, U2.11 (V-), U3.11 (V-), U4.11 (V-), U6.5 (OUT)
ANALOG_IN_1: C52.1, CON3.6
ANALOG_IN_2: C57.1, CON3.4
ANALOG_IN_3: C59.1, CON3.2
ANALOG_OUT_1: CON2.16, R6.2
ANALOG_OUT_2: CON2.14, R13.2
ANALOG_OUT_3: CON2.12, R20.2
ANALOG_OUT_4: CON2.10, R27.2
ANALOG_OUT_5: CON2.8, R34.2
ANALOG_OUT_6: CON2.6, R41.2
ANALOG_OUT_7: CON2.4, R57.2
ANALOG_OUT_8: CON2.2, R64.2
AOP_IN_A+: C5.1, R4.2, U2.3 (+IN_A)
AOP_IN_A-: C4.1, R3.2, U2.2 (-IN_A)
AOP_IN_B+: C10.1, R11.2, U2.5 (+IN_B)
AOP_IN_B-: C9.1, R10.2, U2.6 (-IN_B)
AOP_IN_C+: C15.1, R18.2, U2.10 (+IN_C)
AOP_IN_C-: C14.1, R17.2, U2.9 (-IN_C)
AOP_IN_D+: C20.1, R25.2, U2.12 (+IN_D)
AOP_IN_D-: C19.1, R24.2, U2.13 (-IN_D)
AOP_IN_E+: C25.1, R32.2, U3.3 (+IN_A)
AOP_IN_E-: C24.1, R31.2, U3.2 (-IN_A)
AOP_IN_F+: C30.1, R39.2, U3.5 (+IN_B)
AOP_IN_F-: C29.1, R38.2, U3.6 (-IN_B)
AOP_IN_G+: C69.1, R55.2, U3.10 (+IN_C)
AOP_IN_G-: C68.1, R54.2, U3.9 (-IN_C)
AOP_IN_H+: C74.1, R62.2, U3.12 (+IN_D)
AOP_IN_H-: C73.1, R61.2, U3.13 (-IN_D)
AOP_IN_I-: C53.1, R43.2, R44.1, U4.2 (-IN_A)
AOP_IN_J-: C58.1, R46.2, R47.1, U4.6 (-IN_B)
AOP_IN_K-: C62.1, R49.2, R50.1, U4.9 (-IN_C)
AOP_OUT_A: C4.2, R5.2, R6.1, U2.1 (OUT_A)
AOP_OUT_B: C9.2, R12.2, R13.1, U2.7 (OUT_B)
AOP_OUT_C: C14.2, R19.2, R20.1, U2.8 (OUT_C)
AOP_OUT_D: C19.2, R26.2, R27.1, U2.14 (OUT_D)
AOP_OUT_E: C24.2, R33.2, R34.1, U3.1 (OUT_A)
AOP_OUT_F: C29.2, R40.2, R41.1, U3.7 (OUT_B)
AOP_OUT_G: C68.2, R56.2, R57.1, U3.8 (OUT_C)
AOP_OUT_H: C73.2, R63.2, R64.1, U3.14 (OUT_D)
AOP_OUT_I: C53.2, R45.1, U4.1 (OUT_A)
AOP_OUT_J: C58.2, R48.1, U4.7 (OUT_B)
AOP_OUT_K: C62.2, R51.1, U4.8 (OUT_C)
AOP_OUT_L: U4.13 (-IN_D), U4.14 (OUT_D)
AREFAD1: C39.1, U1.59 (AREFAD1)
BCKAD/DA: BCKAD/DA.TP, CON1.3-12 (12), U1.7 (BCKAD), U1.36 (BCKDA)
DIN1: CON1.3-16 (16), DIN1.TP, U1.37 (DIN1)
DIN2: DIN2.TP, U1.38 (DIN2)
DIN3: DIN3.TP, U1.39 (DIN3)
DIN4: DIN4.TP, U1.40 (DIN4)
DOUT1: CON1.3-22 (22), DOUT1.TP, U1.8 (DOUT1)
DOUT2: DOUT2.TP, U1.9 (DOUT2)
DOUT2(NC): CON1.3-20 (20), DOUT2(NC).TP
DOUT3: DOUT3.TP, U1.10 (DOUT3)
DOUT3(NC): CON1.3-18 (18), DOUT3(NC).TP
GND: C5.2, C10.2, C15.2, C20.2, C25.2, C30.2, C31.2, C32.2, C33.2, C34.2, C35.2, C36.2, C37.2, C38.2, C39.2, C40.2, C41.2, C42.2, C43.2, C44.1, C45.2, C46.1, C47.2, C48.2, C50.2, C51.1, C54.1, C55.1, C56.1, C60.1, C61.1, C63.1, C64.1, C69.2, C74.2, C75.1, C76.2, C77.2, C78.2, CON1.3-2 (2), CON1.3-4 (4), CON1.D-2 (2), CON1.D-4 (4), CON2.1, CON2.3, CON2.5, CON2.7, CON2.9, CON2.11, CON2.13, CON2.15, CON3.1, CON3.3, CON3.5, CON4.1, GND@1.TP, GND@2.TP, R7.1, R14.1, R21.1, R28.1, R35.1, R42.1, R58.1, R65.1, R66.1, R67.1, TP3.TP, U1.2 (AGNDAD2), U1.11 (DGND2), U1.16 (AGNDDA1), U1.33 (AGNDDA2), U1.47 (DGND1), U1.50 (AGNDAD1), U1.65 (EP), U4.12 (+IN_D), U6.3 (GND)
LRCKAD/DA: CON1.3-14 (14), LRCKAD/DA.TP, U1.6 (LRCKAD), U1.35 (LRCKDA)
MC: CON1.3-28 (28), MC.TP, U1.42 (MC/SCL/FMT)
MDI: CON1.3-30 (30), MDI.TP, U1.43 (MDI/SDA/DEMP)
MDO: CON1.3-32 (32), MDO.TP, U1.44 (MDO/ADR1/MD1)
MS: CON1.3-26 (26), MS.TP, U1.45 (MS/ADR0/MD0)
unnamed: C2.2, R2.1
unnamed: C1.2, R1.1
unnamed: C3.1, R1.2, R3.1, R5.1
unnamed: C3.2, R2.2, R4.1, R7.2
unnamed: C7.2, R9.1
unnamed: C6.2, R8.1
unnamed: C8.1, R8.2, R10.1, R12.1
unnamed: C8.2, R9.2, R11.1, R14.2
unnamed: C12.2, R16.1
unnamed: C11.2, R15.1
unnamed: C13.1, R15.2, R17.1, R19.1
unnamed: C13.2, R16.2, R18.1, R21.2
unnamed: C17.2, R23.1
unnamed: C16.2, R22.1
unnamed: C18.1, R22.2, R24.1, R26.1
unnamed: C18.2, R23.2, R25.1, R28.2
unnamed: C22.2, R30.1
unnamed: C21.2, R29.1
unnamed: C23.1, R29.2, R31.1, R33.1
unnamed: C23.2, R30.2, R32.1, R35.2
unnamed: C27.2, R37.1
unnamed: C26.2, R36.1
unnamed: C28.1, R36.2, R38.1, R40.1
unnamed: C28.2, R37.2, R39.1, R42.2
unnamed: C52.2, R43.1
unnamed: C57.2, R46.1
unnamed: C59.2, R49.1
unnamed: C66.2, R53.1
unnamed: C65.2, R52.1
unnamed: C67.1, R52.2, R54.1, R56.1
unnamed: C67.2, R53.2, R55.1, R58.2
unnamed: C71.2, R60.1
unnamed: C70.2, R59.1
unnamed: C49.1, U6.2 (CAP+)
unnamed: C49.2, U6.4 (CAP-)
unnamed: C72.1, R59.2, R61.1, R63.1
unnamed: C72.2, R60.2, R62.1, R65.2
unnamed: POWER.C, R67.2
OVF: OVF.TP, U1.5 (OVF)
SCKI: CON1.3-10 (10), SCKI.TP, U1.41 (SCKI)
SPDIF_DO: CON1.3-24 (24), CON4.2, SPDIF_DO.TP
VCOMAD: C42.1, C54.2, U1.1 (VCOMAD), U4.3 (+IN_A), U4.5 (+IN_B), U4.10 (+IN_C)
VCOMDA: C41.1, U1.15 (VCOMDA)
VIN1+: C55.2, R44.2, R45.2, U1.52 (VIN1+)
VIN1-: C56.2, U1.51 (VIN1-)
VIN2+: C60.2, R47.2, R48.2, U1.54 (VIN2+)
VIN2-: C61.2, U1.53 (VIN2-)
VIN3+: C63.2, R50.2, R51.2, U1.56 (VIN3+)
VIN3-: C64.2, U1.55 (VIN3-)
VIN4-6: C76.1, U1.57 (VIN4-), U1.58 (VIN4+), U1.61 (VIN5-), U1.62 (VIN5+), U1.63 (VIN6-), U1.64 (VIN6+)
VOUT1+: C1.1, U1.31 (VOUT1+)
VOUT1-: C2.1, U1.32 (VOUT1-)
VOUT2+: C6.1, U1.29 (VOUT2+)
VOUT2-: C7.1, U1.30 (VOUT2-)
VOUT3+: C11.1, U1.27 (VOUT3+)
VOUT3-: C12.1, U1.28 (VOUT3-)
VOUT4+: C16.1, U1.25 (VOUT4+)
VOUT4-: C17.1, U1.26 (VOUT4-)
VOUT5+: C21.1, U1.23 (VOUT5+)
VOUT5-: C22.1, U1.24 (VOUT5-)
VOUT6+: C26.1, U1.21 (VOUT6+)
VOUT6-: C27.1, U1.22 (VOUT6-)
VOUT7+: C65.1, U1.19 (VOUT7+)
VOUT7-: C66.1, U1.20 (VOUT7-)
VOUT8+: C70.1, U1.17 (VOUT8+)
VOUT8-: C71.1, U1.18 (VOUT8-)
VREFAD2: C40.1, U1.60 (VREFAD2)
ZERO: U1.13 (ZERO), ZERO.TP

Notes on the sheet:
VCCDAx
VCCADx
VDDx
POWER
Olimex connector
PCM3168a
Output stage
Input stage
AirCat

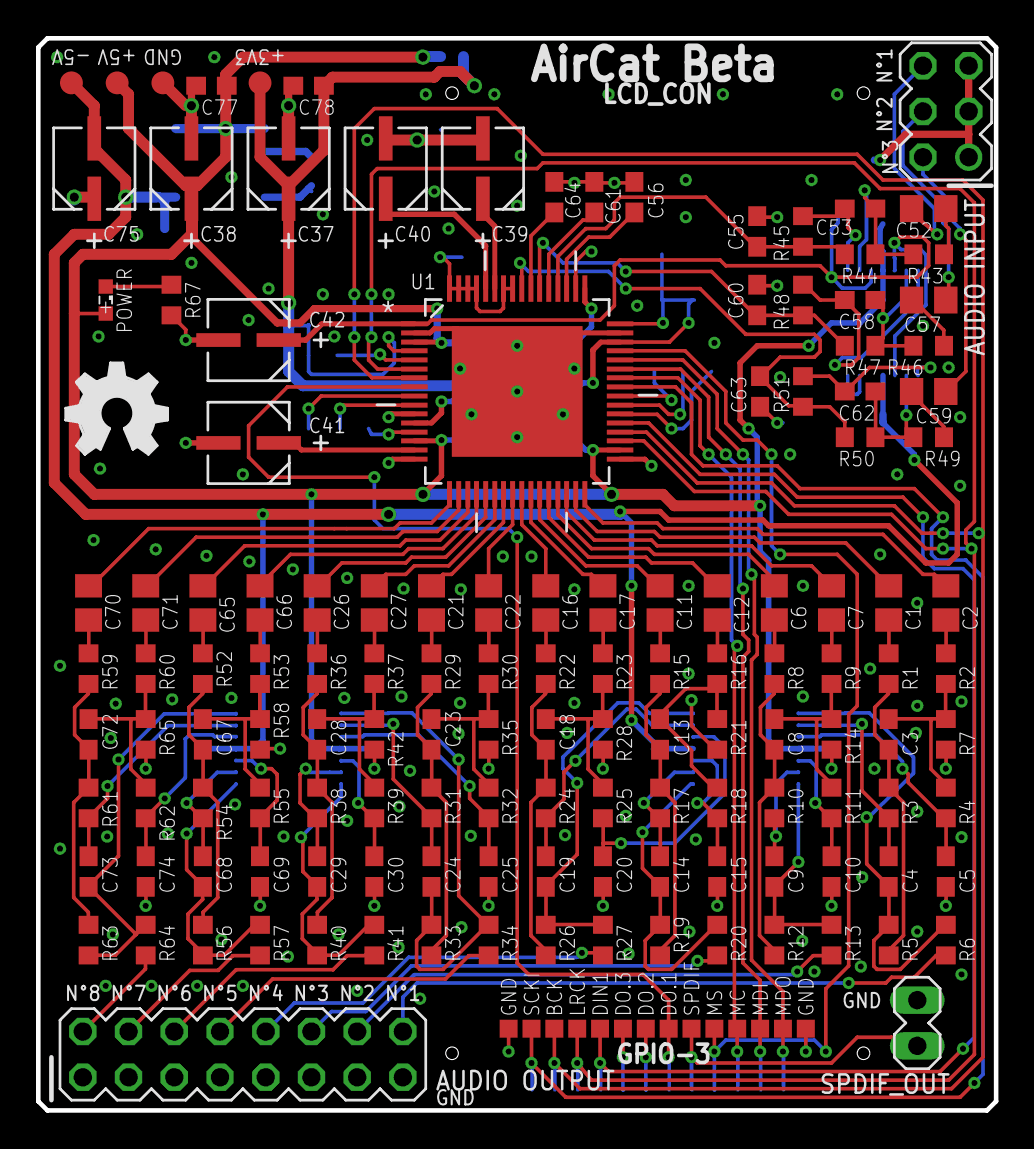
[picture p18: board aircat.brd from above]

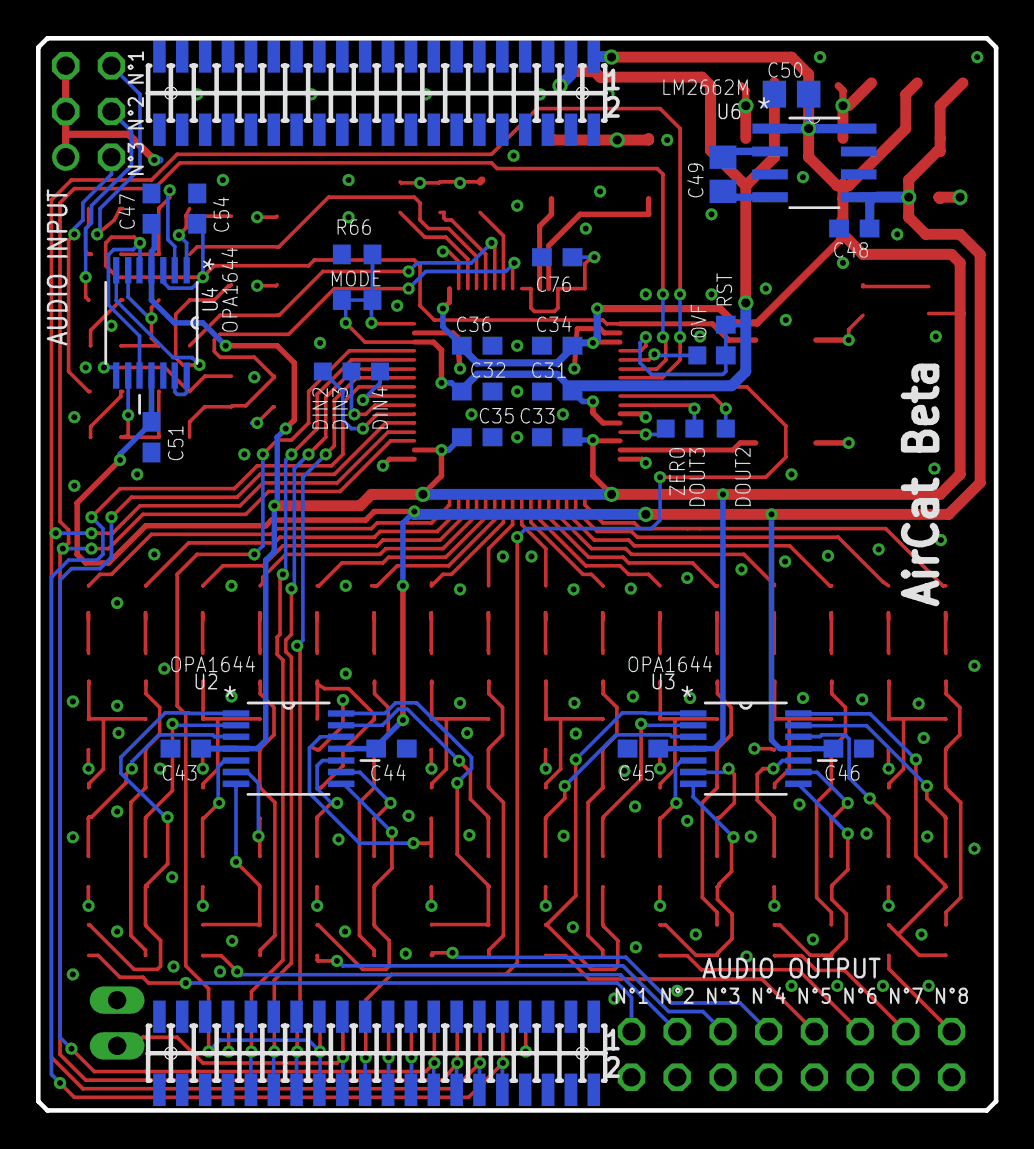
[picture p19: board aircat.brd from below]

Board: 2 copper layers, 53.2 x 59.6 mm, 183 parts (31 on the bottom side), 130 nets.
