Sparod/AirCat-A10/(commit log)

2014-04-27 commit initial. Eagle schematics and boards.
    [aircat.brd, aircat.sch]
2014-04-27 pads added for unused pins
    [aircat.brd, aircat.sch]
2014-04-27 Mode pin connection ok (VDD+pulldown)
    [aircat.brd, aircat.sch]
2014-04-27 all data lines connected
    [aircat.brd]
2014-04-27 componant labels better placed
    [aircat.brd]
2014-04-27 airwire removed
    [aircat.brd]
2014-04-30 added IC's part name labels
    [aircat.brd, aircat.sch]
2014-04-30 little data track path improvment
    [aircat.brd]
2014-04-30 change C48 capacitor
    switch from C0805 to C0603 form factor and from 10µF to 100nF value.
    [aircat.brd, aircat.sch]
2014-05-01 changed 10µF capa form factor
    Changed 10µF 0603" package to 0805" because it's cheaper.
    Minor other optimizations were made too.
    [aircat.brd, aircat.sch]
2014-05-01 added BOM - Bill of Material
    [bom.xlsx]
2014-05-01 BOM corrected
    PCB was was wrong.
    File was corrupted.
    [bom.xlsx]
2014-05-01 updated OSHpark PCB price for volume production
    PCB price is 5x lower if order is > 150 square inches
    [bom.xlsx]
2014-05-01 minor ground plane optimization
    [aircat.brd]
2014-05-08 added power indicating led
    fix #1
    added green led to indicate power on the 5V rail.
    [aircat.brd, aircat.sch, bom.xlsx]
2014-05-08 added SPDIF OUT connector
    fix #4
    [aircat.brd, aircat.sch, bom.xlsx]
2014-05-09 improved the component value labels
    [aircat.brd]
2014-05-09 fix olimex header genre to female
    The two Olimex 2x20 pins 1.27" pitch has been changed from male to
    female.
    [bom.xlsx]
2014-05-09 fixed BOM capacitor reference
    removed the Tape & Reel service, which has a 100+ minimun order number.
    [bom.xlsx]
2014-05-09 added test points for data lines
    fix #7
    [aircat.brd, aircat.sch]
2014-05-09 fixed text alignment issue
    fix #8
    workaround: as no real solution was found, componant name labels were
    all sat to 'bottom-left' alignment and re-positioned by hand.
    [aircat.brd]
2014-05-09 added test points for unused data lines
    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
    [aircat.brd, aircat.sch]
2014-05-09 minor electrical line path optimizations
    [aircat.brd]
2014-05-09 relocated componant laying around GPIO-4
    fix #9
    LM2662 and its capacitors having relocated in order not to enter in
    contact with the GPIO-4 connector.
    [aircat.brd, aircat.sch]
2014-05-09 fixed BOM taxes issues
    fix #5
    Order in US Dollars are converted in Euros.
    French Taxes (VAT) is added in grand total.
    [bom.xlsx]
2014-05-09 fixed incorrect capacitor reference in BOM
    [bom.xlsx]
2014-05-09 added
    componant command basket export from fr.farnell.com
    [fr.farnell.com_command_basket.csv]
2014-05-09 added licence logo
    fix #6
    [aircat.brd, aircat.sch]
2014-05-09 updated pcb images
2014-05-09 updated OSHpark pcb image
2014-05-09 corrected BOM pcb price
    [bom.xlsx]
2014-05-09 Updated BOM and Farnell basket
    [bom.xlsx, fr.farnell.com_command_basket.csv]
2014-05-10 fixed minor unrouted line and typo
    [aircat.brd]
2014-05-10 changed Alpha to Beta title
    [aircat.brd]
2014-05-19 added ground plane on the top layer
    added ground plane on the top layer, for better imunization to EMI.
    [aircat.brd]
